brejcmic/bk2016_arduino_wifi/Dokumentace/RAMPA_VYKRES.pdf

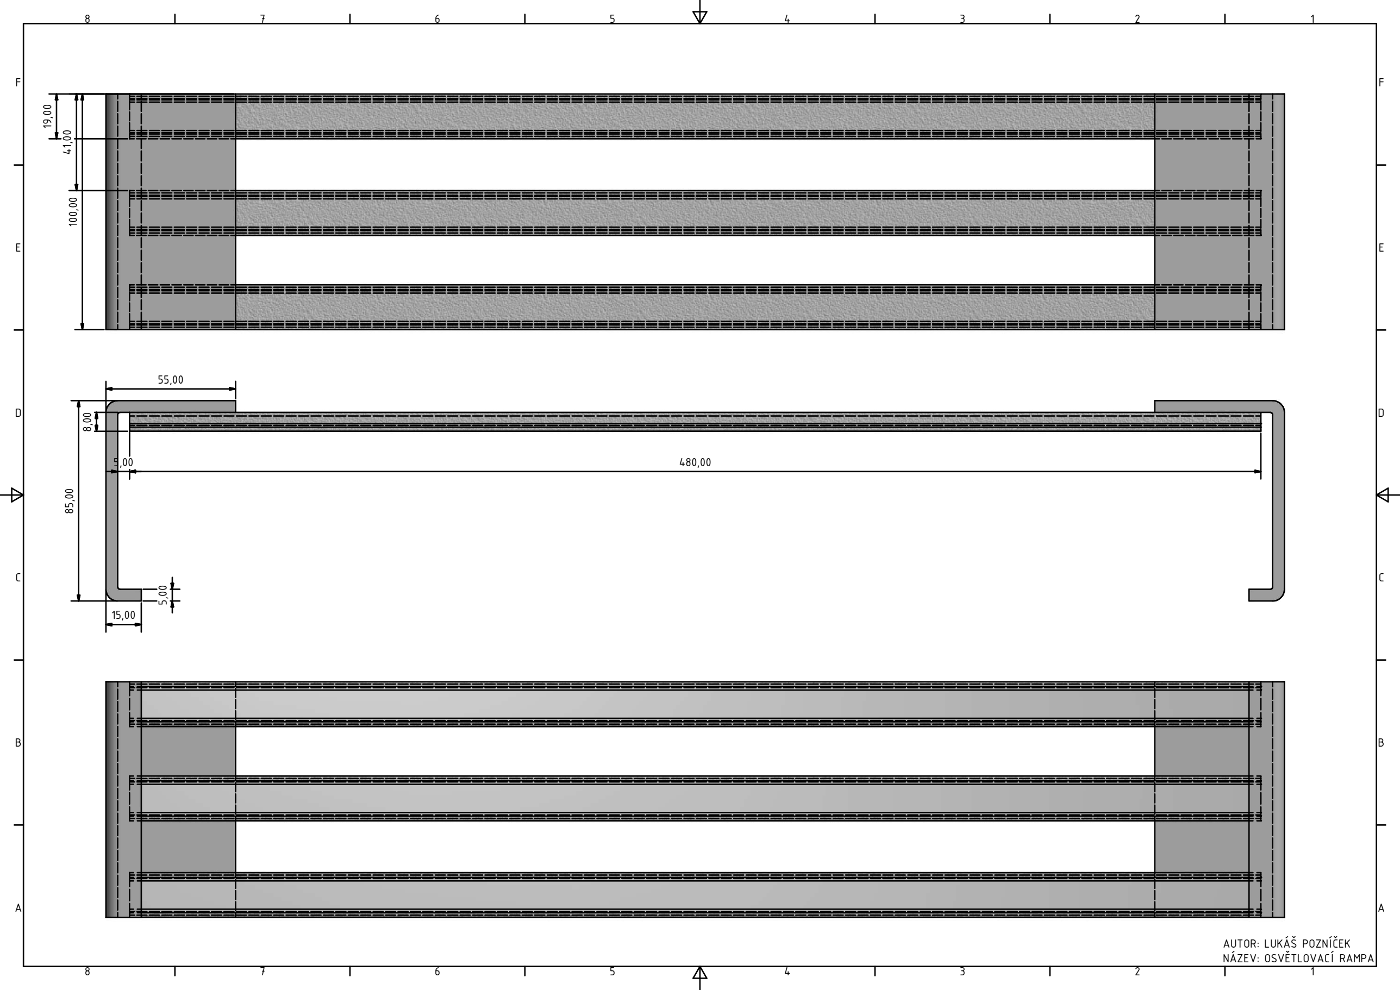
[picture p16: page 1]

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
85,00

55,00

5,00
15,00
5,00 | 480,00

100 0, 0

19,00 41 0, 0

8 0, 0

AUTOR: LUKÁŠ POZNÍČEK
NÁZEV: OSVĚTLOVACÍ RAMPA
