brejcmic/bk2016_arduino_wifi/Dokumentace/BOMbudicLED.xlsx

Sheet: List1
Qty | Device | Value | Package | Parts | Description | Cost [gme.cz] | ID [gme.cz] | Cost x Qty
1 | CPOL-EUE5-10.5 | 10u | E5-10,5 | C7 | POLARIZED CAPACITOR, European symbol | 3 | 123-575 | 3.00
1 | C-EUC0805K | 330n | C0805K | C11 | CAPACITOR, European symbol | 2.30 | 906-119 | 2.30
1 | R-EU_R0805 | 390R | R0805 | R22 | RESISTOR, European symbol | 1.30 | 901-211 | 1.30
1 | 4051N | 4051N | DIL16 | IC2 | CMOS 4051 DIP16 TEXAS INSTRUMENTS | 8.90 | 427-156 | 8.90
1 | R-EU_0207/12 | 4k7 | 0207/12 | R21 | RESISTOR, European symbol | 2.60 | 110-089 | 2.60
1 | 7805T | 7805T | TO220H | IC1 | Positive VOLTAGE REGULATOR | 9.20 | 330-149 | 9.20
1 | ArduinoUNO R3 | ARDUINOR3-UNO | ARDUINOR3 |  |  | 86.10 | eBay | 86.10
1 | CPOL-EUE5-10.5 | CE 1000u/35VIT | E5-10,5 | C10 | POLARIZED CAPACITOR, European symbol | 1.90 | 121-064 | 1.90
1 | ESP01 | ESP01 | ESP01 | IC4 | ESP8266 Serial Wifi Wireless | 47.50 | eBay | 47.50
1 | 7805T | LF33CV | TO220H | IC3 | Transceiver | 22.00 | 330-165 | 22.00
1 | SMKDSP_1,5/2 | SMKDSP_1,5/2 | SMKDSP_1,5/2 | X1 |  | 3.70 | 821-108 | 3.70
1 | SMKDSP_1,5/3 | SMKDSP_1,5/3 | SMKDSP_1,5/3 | X3 |  | 5.50 | 821-109 | 5.50
1 | SMKDSP_1,5/8 | SMKDSP_1,5/8 | SMKDSP_1,5/8 | X2 |  | 14.80 | 821-108 | 14.80
1 | Connector | SOKL 16 | 2x8 2,54mm | 8-channel ANALOG MULTIPLEXER |  | 2.40 | 823-002 | 2.40
1 | Box | KP22 (Z-33) | 190x138x45 |  |  | 79.00 | 622-423 | 79.00
1 | DS3231 AT2432 I2C RTC |  |  |  | Real time clock | 21.80 | eBay | 21.80
2 | Connector | S1G20 2,54mm | 1x6, 2x8, 1x10 | ArduinoUNO |  | 6.20 | 832-017 | 12.40
3 | PINHD-1X4 |  | 1X04 | DS3231RTC, DSP8266 | PIN HEADER | 2.20 | 832-227 | 6.60
3 | C-EUC1206K | 100n | C1206K | C6, C8, C9 | CAPACITOR, European symbol | 1.10 | 905-081 | 3.30
4 | DIODE-DO201-15 |  | DO201-15 | D1, D2, D3, D4 | DIODE | 1.80 | 221-005 | 7.20
4 | R-EU_0207/12 | 1k | 0207/12 | R1, R5, R9, R13 | RESISTOR, European symbol | 2.60 | 110-073 | 10.40
4 | R-EU_0207/12 | 220R | 0207/12 | R3, R7, R11, R15 | RESISTOR, European symbol | 2.60 | 110-057 | 10.40
4 | 2N5551-NPN-TO92-CBE | 2N5551 | TO92-CBE | T1, T2, T3, T4 | NPN Transistror | 1.40 | 215-091 | 5.60
4 | -NPN- TO220 | BD243C | TO220 | Q1, Q2, Q3, Q4 | NPN Transistror | 8.60 | 211-021 | 34.40
5 | LED3MM | 2.2V 5mA | LED3MM | LED1, LED2, LED3, LED4, LED5 | LED | 2.30 | 511-358 | 11.50
6 | Cooler | DO1 | 13x19x13mm |  |  | 6.20 | 620-001 | 37.20
6 | C-EUC1206K | 330n | C1206K | C1, C2, C3, C4, C5, C12 | CAPACITOR, European symbol | 3.19 | 121-343 | 19.14
8 | R-EU_0411/15 | 1R | 0411/15 | R2, R4, R6, R8, R10, R12, R14, R16 | RESISTOR, European symbol | 3.90 | 114-108 | 31.20
10 | R-EU_R0805 | 4k7 | R0805 | R17, R18, R19, R20, R23, R24, R25, R26, R27, R28 | RESISTOR, European symbol | 2.60 | 110-089 | 26.00
79 |  |  |  |  |  |  | Total: | 527.34
1 | Box | 172RC ABS/IP67 | 175x124x51mm |  |  | 275.00 | 627-060 | 275.00

Sheet: List2
Qty | Device | Value | Package | Description | Cost | ID [gme.cz] | Cost x Qty
1 | CPOL-EUE5-10.5 | 10u | E5-10,5 | POLARIZED CAPACITOR | 3 | 123-575 | 3.00
1 | C-EUC0805K | 330n | C0805K | CAPACITOR, European symbol | 2.30 | 906-119 | 2.30
1 | R-EU_R0805 | 390R | R0805 | RESISTOR, European symbol | 1.30 | 901-211 | 1.30
1 | 4051N | 4051N | DIL16 | ANALOG MULTIPLEXER | 8.90 | 427-156 | 8.90
1 | R-EU_0207/12 | 4k7 | 0207/12 | RESISTOR, European symbol | 2.60 | 110-089 | 2.60
1 | 7805T | 7805T | TO220H | Positive VOLTAGE REGULATOR | 9.20 | 330-149 | 9.20
1 | ArduinoUNO R3 | ARDUINOR3-UNO | ARDUINOR3 |  | 86.10 | eBay | 86.10
1 | CPOL-EUE5-10.5 | CE 1000u/35VIT | E5-10,5 | POLARIZED CAPACITOR | 1.90 | 121-064 | 1.90
1 | ESP01 | ESP01 | ESP01 | ESP8266 Serial Wifi Wireless | 47.50 | eBay | 47.50
1 | 7805T | LF33CV | TO220H | Transceiver | 22.00 | 330-165 | 22.00
1 | SMKDSP_1,5/2 | SMKDSP_1,5/2 | SMKDSP_1,5/2 |  | 3.70 | 821-108 | 3.70
1 | SMKDSP_1,5/3 | SMKDSP_1,5/3 | SMKDSP_1,5/3 |  | 5.50 | 821-109 | 5.50
1 | SMKDSP_1,5/8 | SMKDSP_1,5/8 | SMKDSP_1,5/8 |  | 14.80 | 821-108 | 14.80
1 | Connector | SOKL 16 | 2x8 2,54mm |  | 2.40 | 823-002 | 2.40
1 | Box | KP22 (Z-33) | 190x138x45 |  | 79.00 | 622-423 | 79.00
1 | DS3231 | AT2432 I2C | RTC | Real time clock | 21.80 | eBay | 21.80
1 | DIL Socket 8 |  | 2,54x0,6mm |  | 1.50 | 823-011 | 1.50
1 | DIL Socket 16 |  | 2,54x0,6mm |  | 2.40 | 823-002 | 2.40
1 | 24LC512-I/P | 512K bits (x8) | DIP8 | CMOS Serial EEPROM | 43.00 | 414-056 | 43.00
2 | Connector | S1G20 2,54mm | 1x6, 2x8, 1x10 |  | 6.20 | 832-017 | 12.40
3 | PINHD-1X4 |  | 1X04 | PIN HEADER | 2.20 | 832-227 | 6.60
3 | C-EUC1206K | 100n | C1206K | CAPACITOR, European symbol | 1.10 | 905-081 | 3.30
4 | DIODE-DO201-15 |  | DO201-15 | DIODE | 1.80 | 221-005 | 7.20
4 | R-EU_0207/12 | 1k | 0207/12 | RESISTOR, European symbol | 2.60 | 110-073 | 10.40
4 | R-EU_0207/12 | 220R | 0207/12 | RESISTOR, European symbol | 2.60 | 110-057 | 10.40
4 | 2N5551-NPN-TO92-CBE | 2N5551 | TO92-CBE | NPN Transistror | 1.40 | 215-091 | 5.60
4 | -NPN- TO220 | BD243C | TO220 | NPN Transistror | 8.60 | 211-021 | 34.40
5 | LED3MM | 2.2V 5mA | LED3MM | LED | 2.30 | 511-358 | 11.50
6 | Cooler | DO1 | 13x19x13mm |  | 6.20 | 620-001 | 37.20
6 | C-EUC1206K | 330n | C1206K | CAPACITOR, European symbol | 3.19 | 121-343 | 19.14
8 | R-EU_0411/15 | 1R | 0411/15 | RESISTOR, European symbol | 3.90 | 114-108 | 31.20
10 | R-EU_R0805 | 4k7 | R0805 | RESISTOR, European symbol | 2.60 | 110-089 | 26.00
82 |  |  |  |  |  | Total: | 574.24
