brejcmic/bk2016_arduino_wifi/EagleSch/AkvarkoV2/budicLED.brd

## EAGLE design EagleSch/AkvarkoV2/budicLED.brd (2016-04-22)

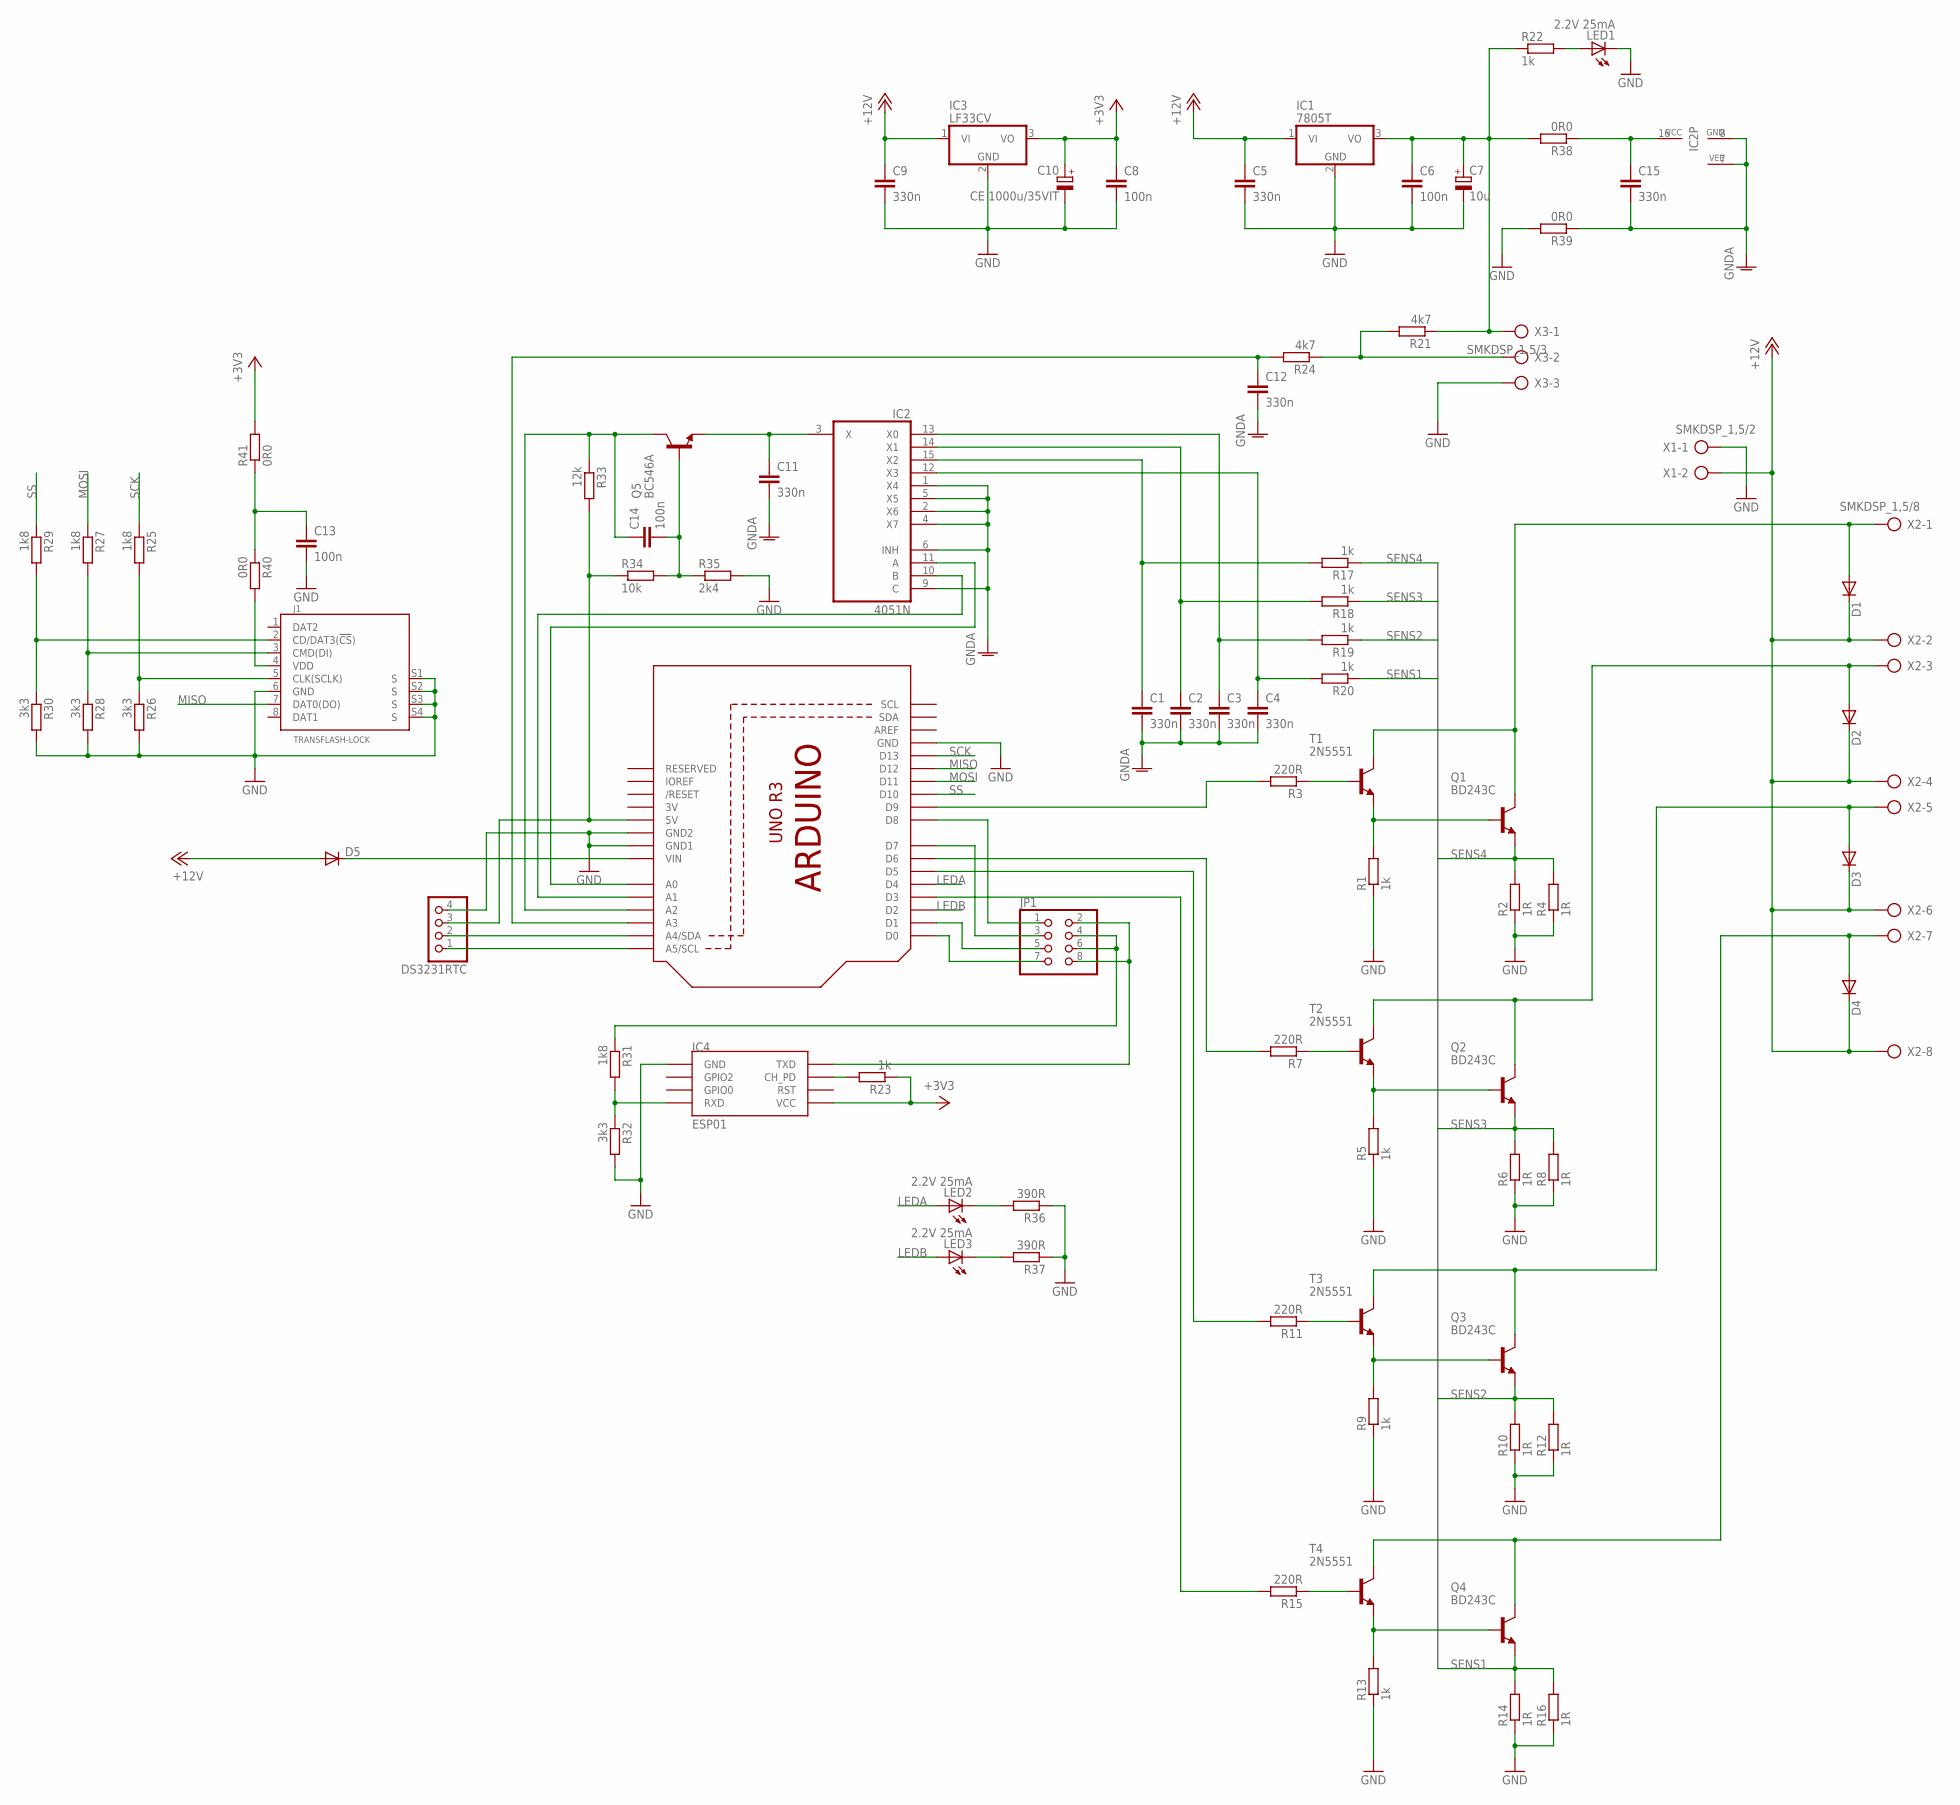
[picture p17: schematic budicLED.sch]

Parts:
C1, C2, C3, C4, C5, C9, C11, C12, C15: 330n; C1206K
C6, C8, C13, C14: 100n; C1206K
C7: 10u; E5-10,5
C10: CE 1000u/35VIT; E5-10,5
D1, D2, D3, D4: DIODE-DO201-15; DO201-15
D5: DIODE-MELF-MLL41; MELF-MLL41
DS3231RTC: PINHD-1X4; 1X04
IC1: 7805T; TO220H
IC2: 4051N; DIL16
IC3: LF33CV; TO220H
IC4: ESP01
J1: TRANSFLASH-LOCK; TRANSFLASH-LOCK-SOCK
JP1: PINHD-2X4; 2X04
LED1, LED2, LED3: 2.2V 25mA; LED3MM
Q1, Q2, Q3, Q4: BD243C; TO220
Q5: BC546A; TO92-EBC
R1, R5, R9, R13: 1k; 0207/12
R2, R4, R6, R8, R10, R12, R14, R16: 1R; 0411/15
R3, R7, R11, R15: 220R; 0207/12
R17, R18, R19, R20, R22, R23: 1k; R0805
R21: 4k7; 0207/12
R24: 4k7; 0207/15
R25, R27, R29, R31: 1k8; 0207/12
R26, R28, R30, R32: 3k3; 0207/12
R33: 12k; 0207/12
R34: 10k; 0207/12
R35: 2k4; 0207/12
R36, R37: 390R; 0207/12
R38: 0R0; 0207/15
R39, R40, R41: 0R0; 0207/12
T1, T2, T3, T4: 2N5551; TO92-CBE
U1: ARDUINOR3-DIMENSION; ARDUINOR3
X1: SMKDSP_1,5/2
X2: SMKDSP_1,5/8
X3: SMKDSP_1,5/3

Connections:
3V: U1.3V
+3V3: C8.1, C10.+, IC3.3 (VO), IC4.VCC, R23.1, R41.2
+12V: C5.1, C9.1, D1.C, D2.C, D3.C, D4.C, D5.A, IC1.1 (VI), IC3.1 (VI), X1.2, X2.2, X2.4, X2.6, X2.8
GND: C5.2, C6.2, C7.-, C8.2, C9.2, C10.-, C13.2, DS3231RTC.4, IC1.2 (GND), IC3.2 (GND), IC4.GND, J1.6 (GND), J1.S1 (S), J1.S2 (S), J1.S3 (S), J1.S4 (S), LED1.K (C), R1.1, R2.1, R4.1, R5.1, R6.1, R8.1, R9.1, R10.1, R12.1, R13.1, R14.1, R16.1, R26.2, R28.2, R30.2, R32.2, R35.2, R36.1, R37.1, R39.2, U1.GND, U1.GND1, U1.GND2, X1.1, X3.3
GNDA: C1.2, C2.2, C3.2, C4.2, C11.2, C12.2, C15.2, IC2.1 (X4), IC2.2 (X6), IC2.4 (X7), IC2.5 (X5), IC2.6 (INH), IC2.7 (VEE), IC2.8 (GND), IC2.9 (C), R39.1
LEDA: LED2.A, U1.D4
LEDB: LED3.A, U1.D2
MISO: J1.7 (DAT0(DO)), U1.D12
MOSI: R27.1, U1.D11
unnamed: Q1.1 (B), R1.2, T1.E
unnamed: D1.A, Q1.2 (C), T1.C, X2.1
unnamed: R3.1, T1.B
unnamed: D2.A, Q2.2 (C), T2.C, X2.3
unnamed: D3.A, Q3.2 (C), T3.C, X2.5
unnamed: Q2.1 (B), R5.2, T2.E
unnamed: D4.A, Q4.2 (C), T4.C, X2.7
unnamed: R7.1, T2.B
unnamed: Q3.1 (B), R9.2, T3.E
unnamed: R21.2, R24.1, X3.2
unnamed: R11.1, T3.B
unnamed: Q4.1 (B), R13.2, T4.E
unnamed: DS3231RTC.1, U1.A5 (A5/SCL)
unnamed: R15.1, T4.B
unnamed: R11.2, U1.D5
unnamed: R3.2, U1.D9
unnamed: IC4.CH_PD, R23.2
unnamed: C14.1, Q5.C, R33.1, U1.A2
unnamed: C14.2, Q5.B, R34.2, R35.1
unnamed: IC4.TX (TXD), JP1.2, JP1.8
unnamed: C12.1, R24.2, U1.A3
unnamed: R7.2, U1.D6
unnamed: C6.1, C7.+, IC1.3 (VO), R21.1, R22.1, R38.2, X3.1
unnamed: DS3231RTC.2, U1.A4 (A4/SDA)
unnamed: JP1.4, JP1.6, R31.1
unnamed: IC2.11 (A), U1.A0
unnamed: LED1.A, R22.2
unnamed: JP1.3, U1.D7
unnamed: C1.1, IC2.15 (X2), R17.2
unnamed: C2.1, IC2.14 (X1), R18.2
unnamed: C3.1, IC2.13 (X0), R19.2
unnamed: J1.5 (CLK(SCLK)), R25.2, R26.1
unnamed: C4.1, IC2.12 (X3), R20.2
unnamed: IC2.10 (B), U1.A1
unnamed: R15.2, U1.D3
unnamed: J1.3 (CMD(DI)), R27.2, R28.1
unnamed: J1.2 (CD/DAT3(!CS!)), R29.2, R30.1
unnamed: JP1.5, U1.D1
unnamed: IC4.RX (RXD), R31.2, R32.1
unnamed: C11.1, IC2.3 (X), Q5.E
unnamed: JP1.7, U1.D0
unnamed: JP1.1, U1.D8
unnamed: LED2.K (C), R36.2
unnamed: DS3231RTC.3, R33.2, R34.1, U1.5V
unnamed: LED3.K (C), R37.2
unnamed: C15.1, IC2.16 (VCC), R38.1
unnamed: J1.4 (VDD), R40.2
unnamed: D5.C, U1.VIN
unnamed: C13.1, R40.1, R41.1
SCK: R25.1, U1.D13
SENS1: Q4.3 (E), R14.2, R16.2, R20.1
SENS2: Q3.3 (E), R10.2, R12.2, R19.1
SENS3: Q2.3 (E), R6.2, R8.2, R18.1
SENS4: Q1.3 (E), R2.2, R4.2, R17.1
SS: R29.1, U1.D10

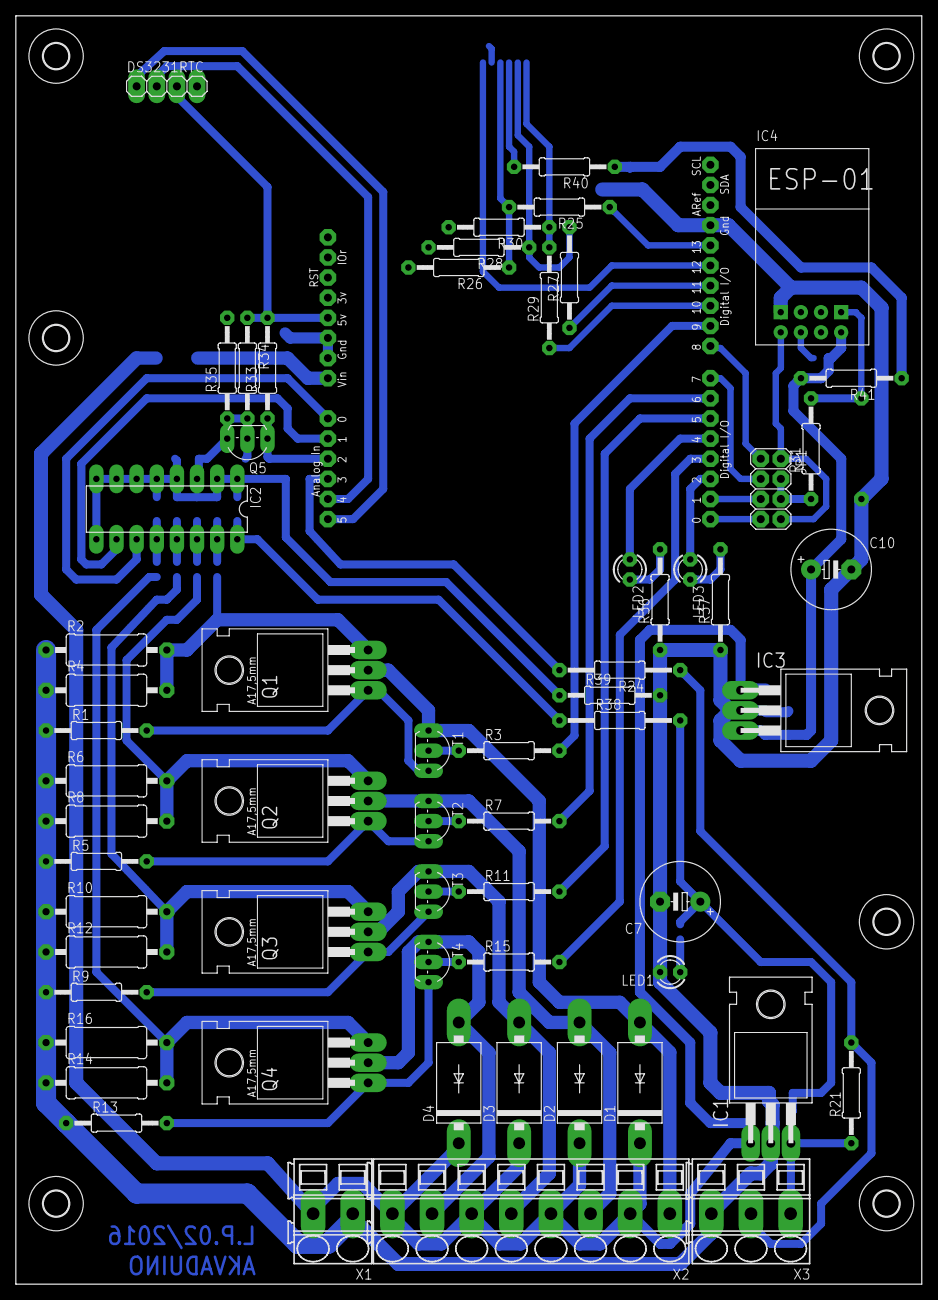
[picture p18: board budicLED.brd from above]

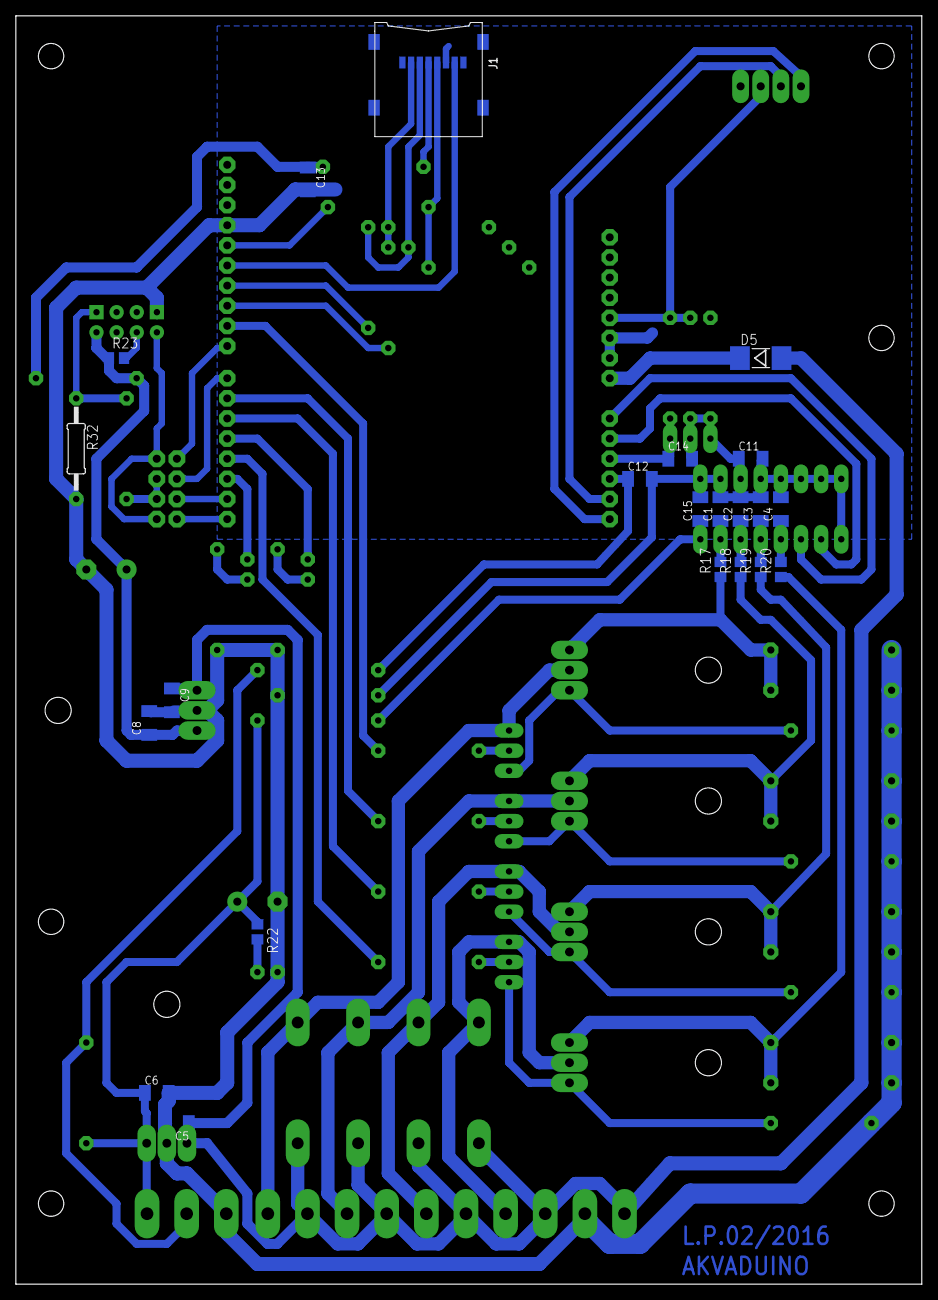
[picture p19: board budicLED.brd from below]

Board: 2 copper layers, 114.3 x 160.0 mm, 90 parts (22 on the bottom side), 63 nets.

Other parts of the board:
U$1, U$2, U$3, U$4, U$5, U$6: 3,2
