brejcmic/bk2016_arduino_wifi/(commit log)

2016-03-18 Funkcni kod, ktery pres webovy prohlizec rozsveci a zhasina ledku na pinu 7.
2016-03-30 Verze zakladove desky akvaduino pred upravami
    [budicLED.brd, budicLED.sch]
2016-03-30 Pridan slot pro SD kartu, odstraneny signalizacni diody.
    [budicLED.brd, budicLED.sch]
2016-03-31 Na DPS: - upraveno napajeni - zmenena pouzdra rezistoru u SD karty - seriova linka vyvedena na kolikovou listu - zvetsena sirka spoje GND, doplnen jeden filtracni kapacitor k SD slotu
    [budicLED.brd, budicLED.sch]
2016-03-31 DPS pred vyrobou, nutna kontrola rozmeru.
    [budicLED.brd]
2016-04-01 DPS: - pridany LED, - dratove propojky nahrazeny reszistory 0R0, - doplnena rozlita med, - pridan zesilovaci prvek (tranzistor) k AD prevodnikum od snimani proudu ve vykonovem obvodu, - pridano nekol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
    [budicLED.brd, budicLED.sch]
2016-04-01 DPS: - posilena tloustka vykonove zeme a privodu napajeni k Arduino UNO
    [budicLED.brd]
2016-04-02 DPS: - RTC modul obracen o 90°, jinak se nevejde do krabicky.
    [budicLED.brd, budicLED.sch]
2016-04-02 Pripravena vyrobni data.
    [botom.gbr, drills.gbr]
2016-04-05 Doplnen BOM
    [BOMbudicLED.xlsx]
2016-04-06 DPS: - vytvorena objednavka soucastek v GME
    [BOM.csv, GMEobj.xlsx, budicLED.brd, budicLED.sch]
2016-04-14 DPS: - opraven chybejici propoj - opraveno zrcadleni soucastek
    [budicLED.brd]
2016-04-15 Ostranen soubor epf a doplneny popisky vyvodu u diod.
    [budicLED.sch]
2016-04-20 - pridelany PWM signaly - opravena chyba v cekani na potvrzeni odeslani packetu
2016-04-20 - upraveny hodnoty odporu u zesilovace napeti z bocniku - pridana dioda do napajeciho vstupu ARDUINO
    [budicLED.brd, budicLED.sch]
2016-04-22 DPS: - opravena chybna cesta u rezistoru R1
    [budicLED.brd]
